BartekClk/MonitorLight/MonitorLight/MonitorLight.kicad_pcb

## KiCad design MonitorLight/MonitorLight.kicad_pcb (2026-10-10)

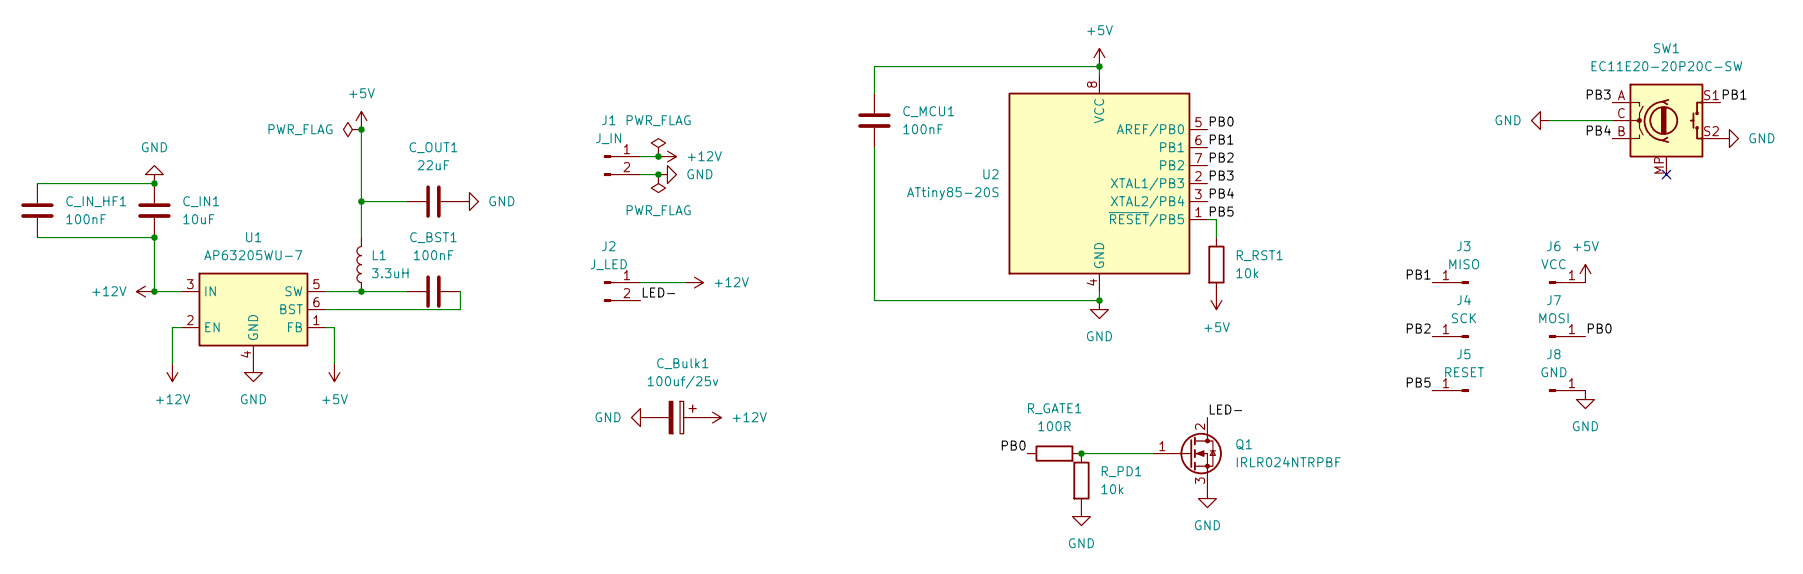
[picture p1: schematic MonitorLight.kicad_sch]

Parts:
C_BST1: 100nF; C_0805_2012Metric
C_Bulk1: 100uf/25v; C_Radial_D6.3mm_H11.0mm_P2.50mm
C_IN1: 10uF; C_0805_2012Metric
C_IN_HF1: 100nF; C_0805_2012Metric
C_MCU1: 100nF; C_0805_2012Metric
C_OUT1: 22uF; C_0805_2012Metric
J1: J_IN; SolderPads_01x02_M
J2: J_LED; SolderPads_01x02_M
J3: MISO; InspectionPads_01
J4: SCK; InspectionPads_01
J5: RESET; InspectionPads_01
J6: VCC; InspectionPads_01
J7: MOSI; InspectionPads_01
J8: GND; InspectionPads_01
L1: 3.3uH; L_Taiyo-Yuden_MD-2020
Q1: IRLR024NTRPBF
R_GATE1: 100R; R_0805_2012Metric
R_PD1: 10k; R_0805_2012Metric
R_RST1: 10k; R_0805_2012Metric
SW1: EC11E20-20P20C-SW; RotaryEncoder_Alps_EC11E-Switch_Vertical_H20mm_CircularMoun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
U1: AP63205WU-7; TSOT-23-6
U2: ATtiny85-20S; SOIC-8_5.3x5.3mm_P1.27mm

Connections:
+5V: C_MCU1.1, C_OUT1.1, J6.1 (Pin_1_1), L1.2, R_RST1.2, U1.1 (FB), U2.8 (VCC)
+12V: C_Bulk1.1, C_IN1.2, C_IN_HF1.2, J1.1, J2.1, U1.2 (EN), U1.3 (IN)
/LED-: J2.2, Q1.2 (D)
/PB0: J7.1 (Pin_1_1), R_GATE1.1, U2.5 (AREF/PB0)
/PB1: J3.1 (Pin_1_1), SW1.S1, U2.6 (PB1)
/PB2: J4.1 (Pin_1_1), U2.7 (PB2)
/PB3: SW1.A, U2.2 (XTAL1/PB3)
/PB4: SW1.B, U2.3 (XTAL2/PB4)
/PB5: J5.1 (Pin_1_1), R_RST1.1, U2.1 (~RESET/PB5)
GND: C_Bulk1.2, C_IN1.1, C_IN_HF1.1, C_MCU1.2, C_OUT1.2, J1.2, J8.1 (Pin_1_1), Q1.3 (S), R_PD1.2, SW1.C, SW1.S2, U1.4 (GND), U2.4 (GND)
unnamed: Q1.1 (G), R_GATE1.2, R_PD1.1
unnamed: C_BST1.2, U1.6 (BST)
unnamed: C_BST1.1, L1.1, U1.5 (SW)

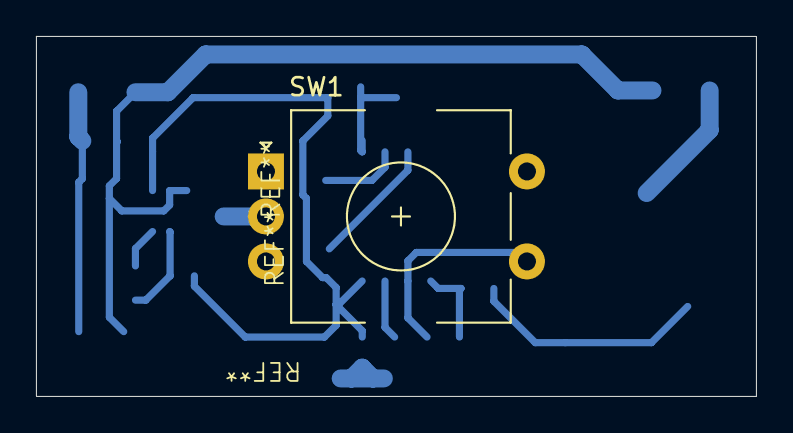
[picture p2: board MonitorLight.kicad_pcb from above]

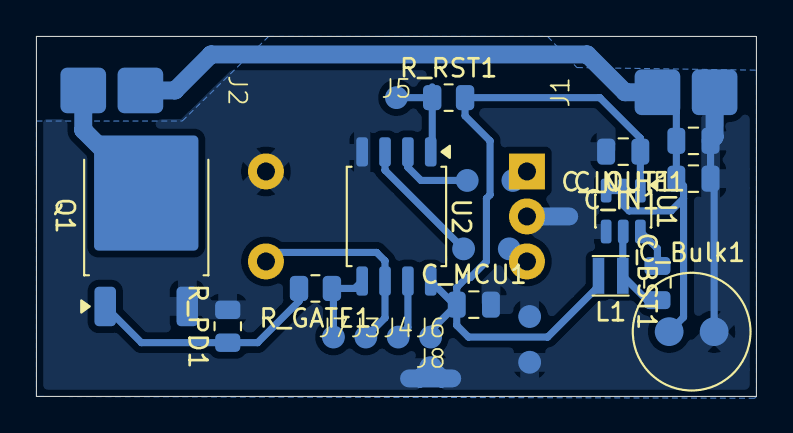
[picture p3: board MonitorLight.kicad_pcb from below]

Board: 2 copper layers, 40.0 x 20.0 mm, 22 parts (21 on the bottom side), 13 nets.
